UTHAI-Humanoid/UTHAI-Hardware/Mechanics/UTHAI_Properties.xlsx

 | UTHAI Humanoid
URDF | Link | Mass [kg] | Centor of mass [m] |  |  | Inertia [kg*m^2] taken at the center of mass |  |  |  |  |  | Inertia [kg*m^2] taken at the coordinate |  |  |  |  |  | Link
 |  |  | x | y | z | xx | xy | xz | yy | yz | zz | xx | xy | xz | yy | yz | zz
 | All | 3.56700000 | -0.00836813 | 0.00000000 | -0.31830739 | 0.31081793 | -0.00000313 | -0.00035731 | 0.28471758 | -0.00000024 | 0.03125190 | 0.67222493 | -0.00000313 | 0.00914389 | 0.64637436 | -0.00000037 | 0.03150169 | All
 | Body | 0.86500000 | -0.00557436 | 0.00000000 | -0.02356598 | 0.00656431 | -0.00000003 | -0.00000466 | 0.00067608 | 0.00000000 | 0.00664141 | 0.00704469 | -0.00000003 | 0.00010897 | 0.00118334 | 0.00000001 | 0.00666829 | Body
 | R Hip Yaw | 0.09100000 | 0.00000000 | -0.02500000 | -0.00735017 | 0.00014158 | 0.00000000 | 0.00000000 | 0.00002022 | 0.00000000 | 0.00014316 | 0.00020337 | 0.00000000 | 0.00000000 | 0.00002514 | 0.00001672 | 0.00020004 | R Hip Yaw
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
