UTHAI-Humanoid/UTHAI-Hardware/Mechanics/Drawing/Foot/Feet_L.JPG

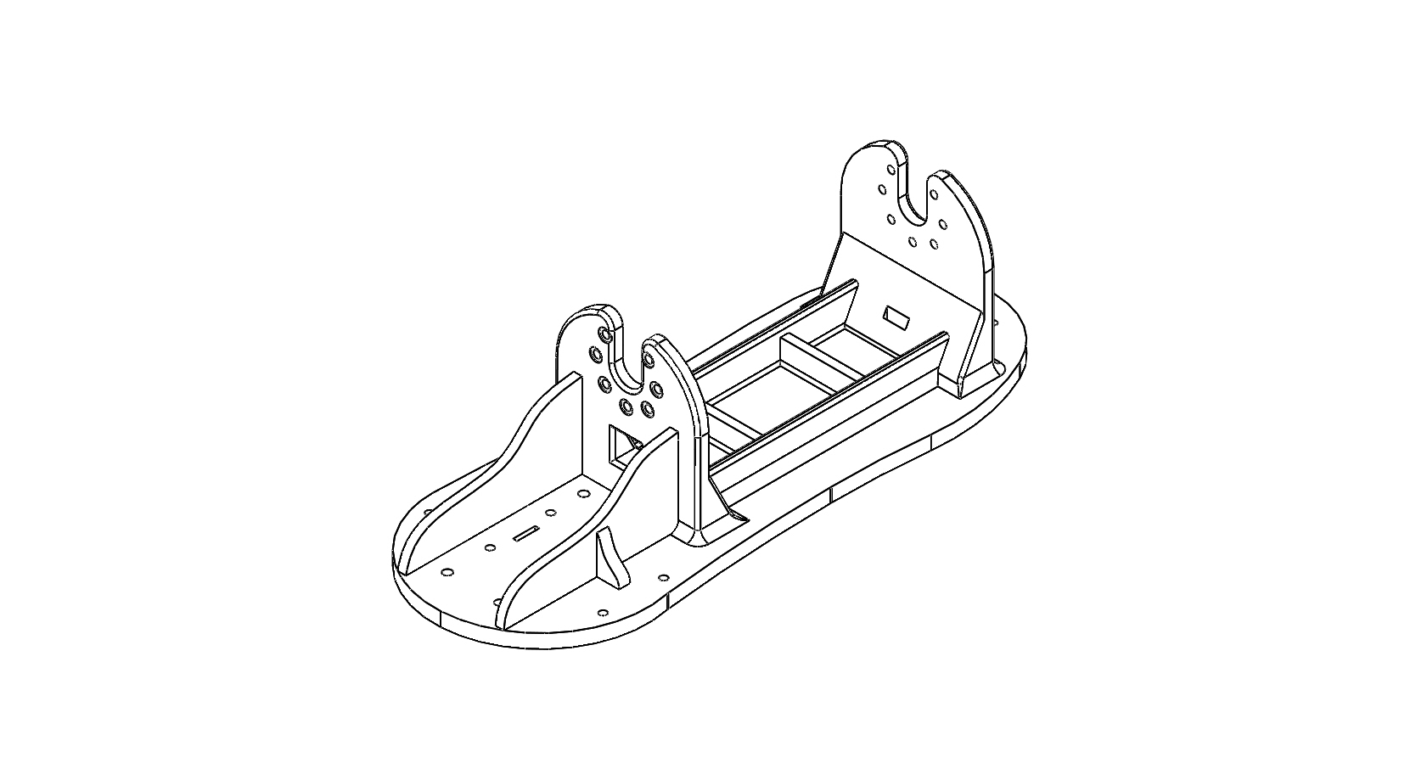
Mechanics/Drawing/Foot/Feet_L.JPG
