UTHAI-Humanoid/UTHAI-Hardware/Mechanics/Drawing/Hip.JPG

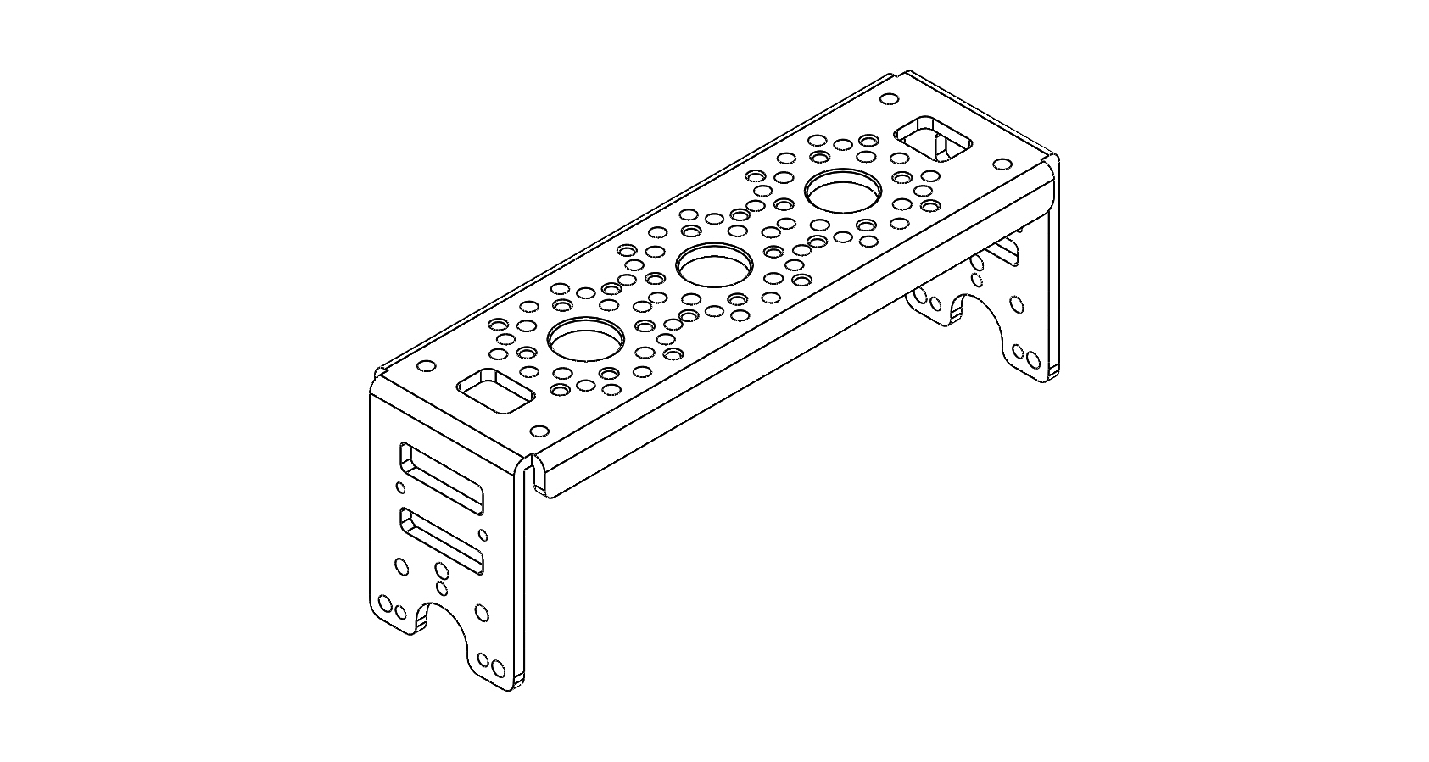
Mechanics/Drawing/Hip.JPG
