UTHAI-Humanoid/UTHAI-Hardware/Mechanics/Drawing/HipAnkle/LAnkle.JPG

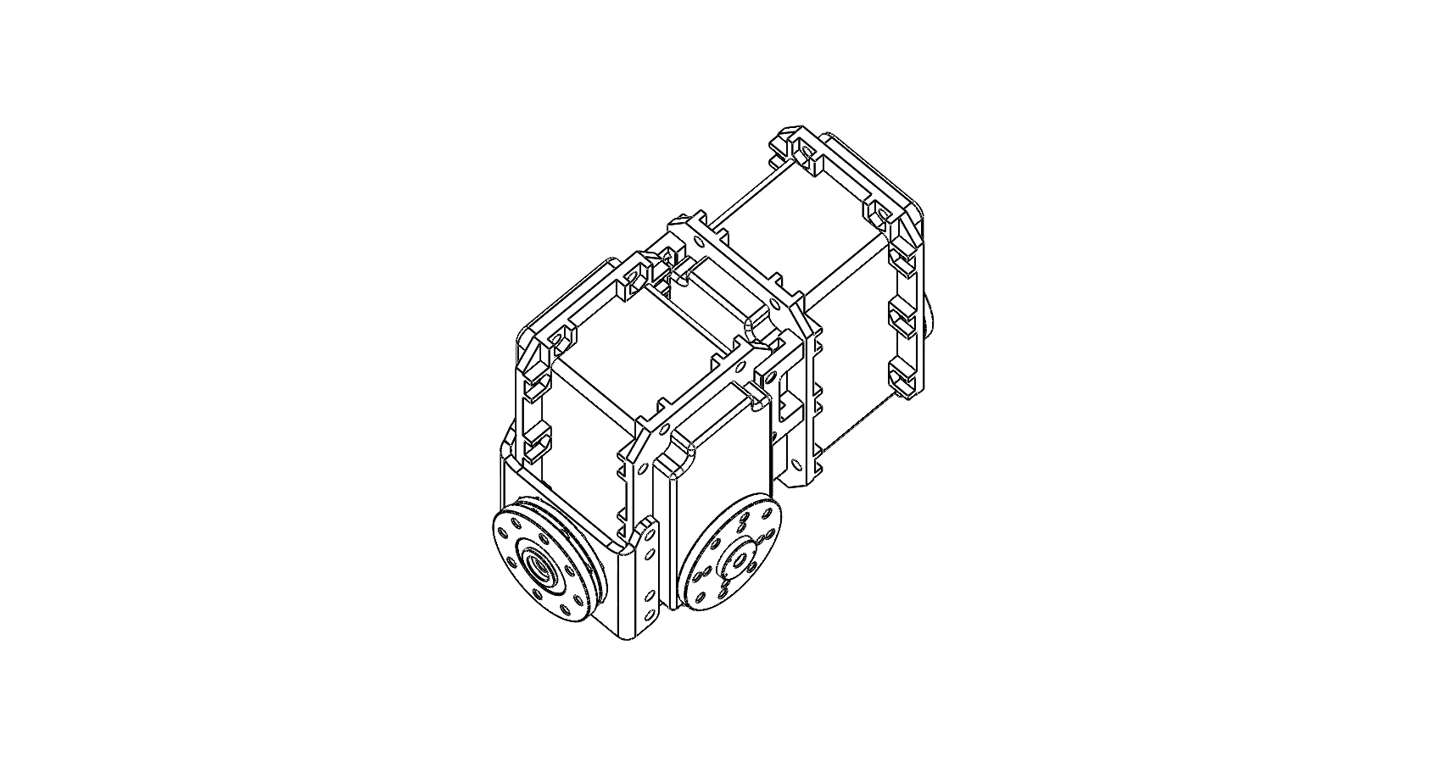
Mechanics/Drawing/HipAnkle/LAnkle.JPG
