UTHAI-Humanoid/UTHAI-Hardware/Mechanics/Drawing/HipAnkle/LHip.JPG

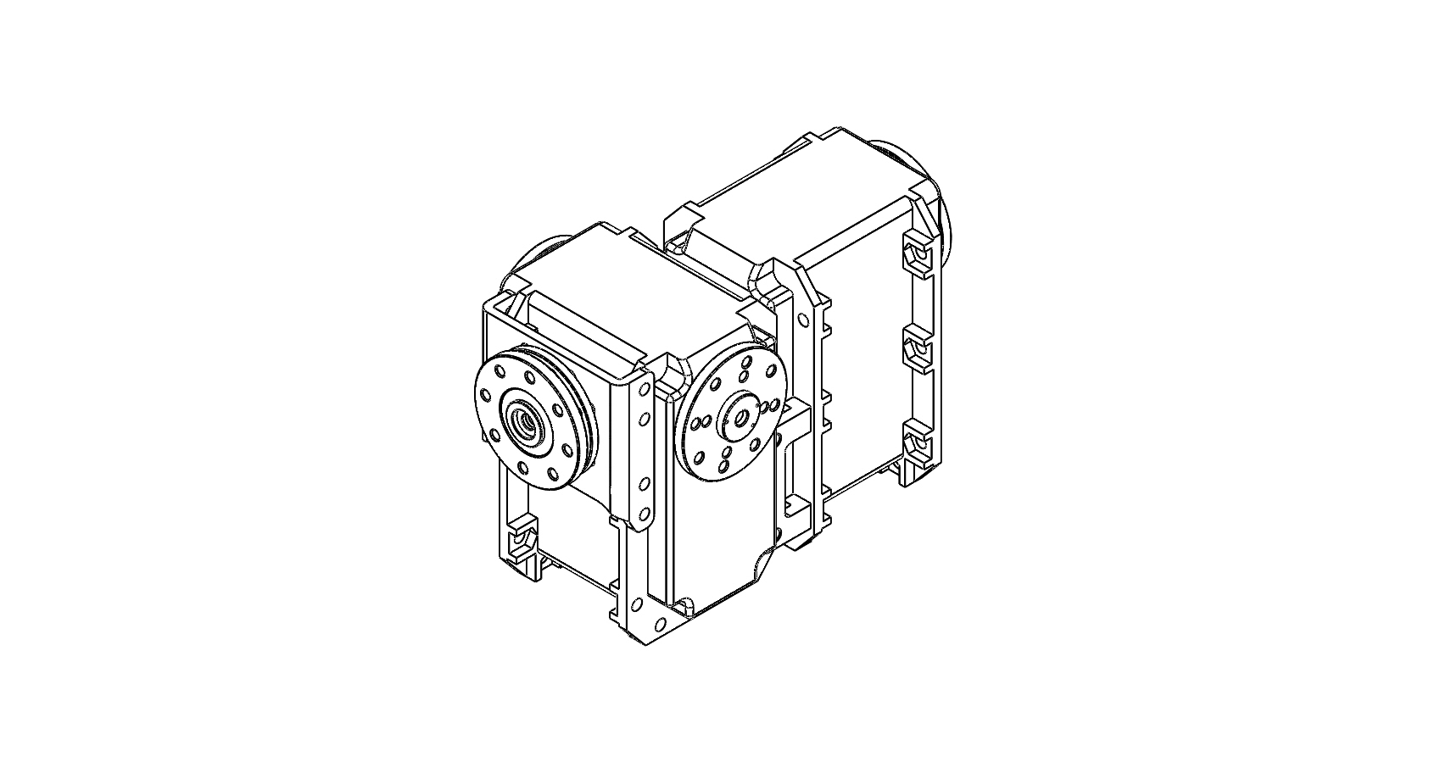
Mechanics/Drawing/HipAnkle/LHip.JPG
