UTHAI-Humanoid/UTHAI-Hardware/Mechanics/Drawing/HipAnkle/LHipC.JPG

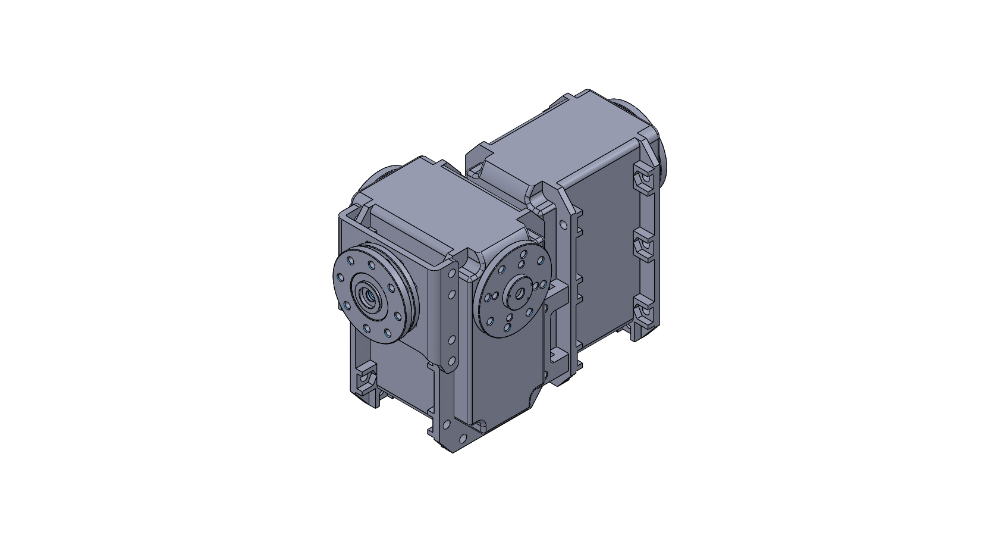
Mechanics/Drawing/HipAnkle/LHipC.JPG
