UTHAI-Humanoid/UTHAI-Hardware/Mechanics/Drawing/Pelvis.JPG

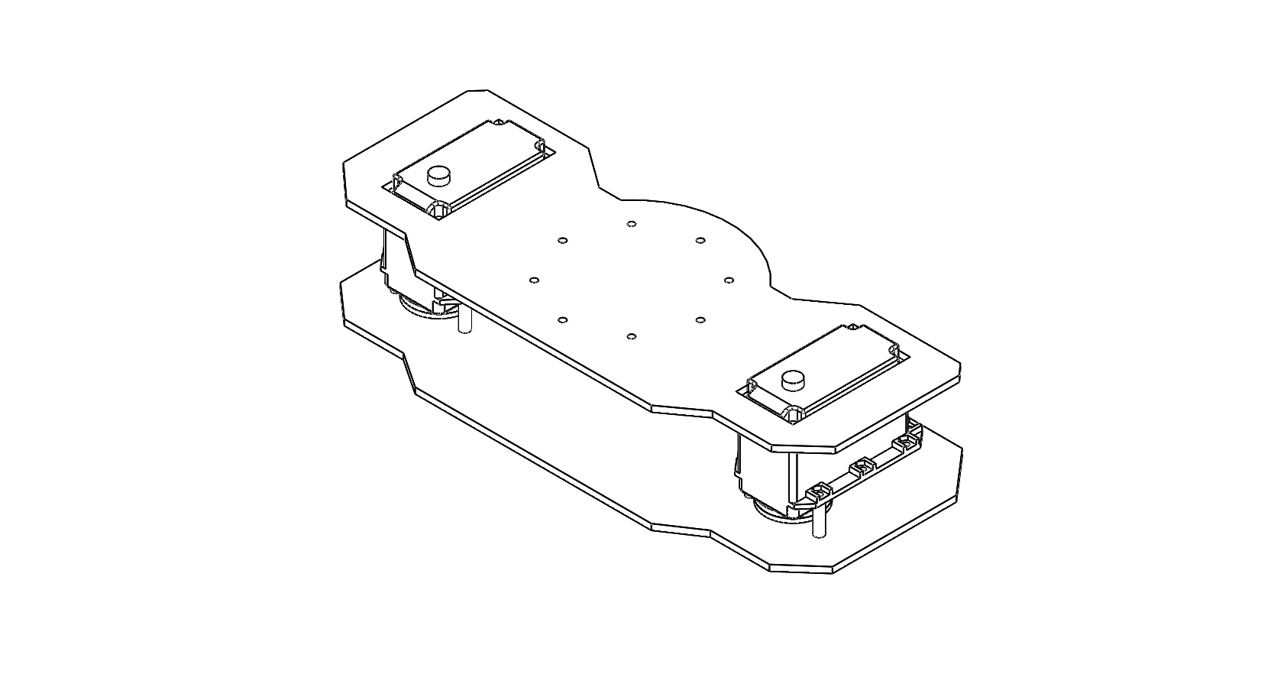
Mechanics/Drawing/Pelvis.JPG
