UTHAI-Humanoid/UTHAI-Hardware/Mechanics/Drawing/Shin/Shin.JPG

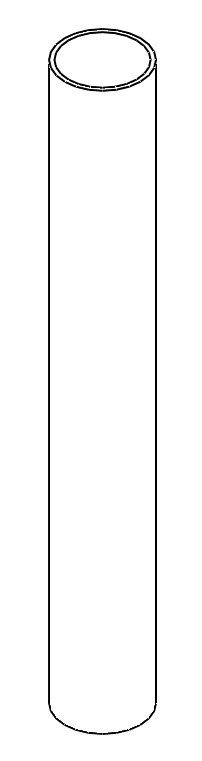
Mechanics/Drawing/Shin/Shin.JPG
