UTHAI-Humanoid/UTHAI-Hardware/Mechanics/Drawing/Shin/Shin_high.JPG

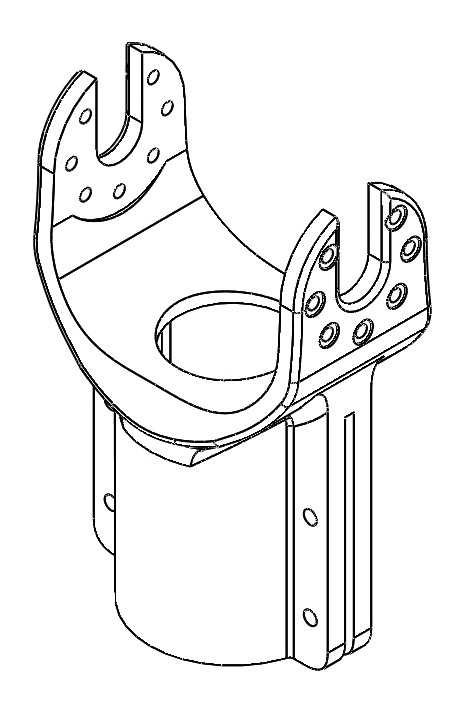
Mechanics/Drawing/Shin/Shin_high.JPG
