UTHAI-Humanoid/UTHAI-Hardware/Mechanics/Drawing/Shin/Shin_low.JPG

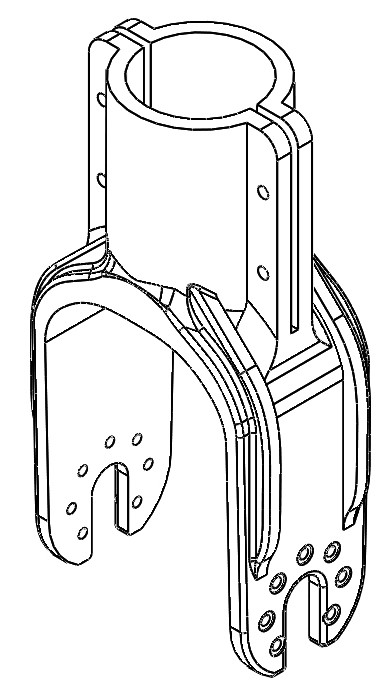
Mechanics/Drawing/Shin/Shin_low.JPG
