UTHAI-Humanoid/UTHAI-Hardware/Mechanics/Drawing/Shin/ShinAssem.JPG

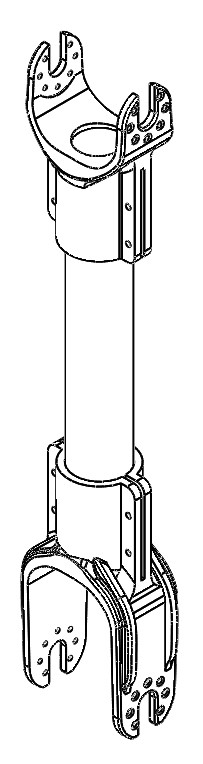
Mechanics/Drawing/Shin/ShinAssem.JPG
