UTHAI-Humanoid/UTHAI-Hardware/Mechanics/Drawing/Shin/ShinAssemC.JPG

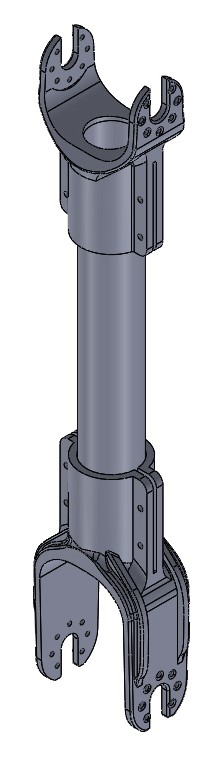
Mechanics/Drawing/Shin/ShinAssemC.JPG
