UTHAI-Humanoid/UTHAI-Hardware/Mechanics/Drawing/Thigh/EX-106+hon.JPG

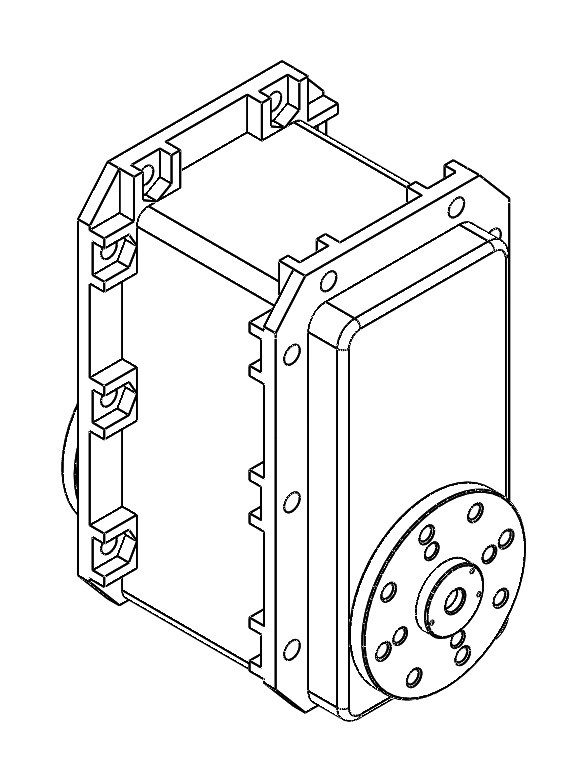
Mechanics/Drawing/Thigh/EX-106+hon.JPG
