UTHAI-Humanoid/UTHAI-Hardware/Mechanics/Drawing/Thigh/LEX-106+hon.JPG

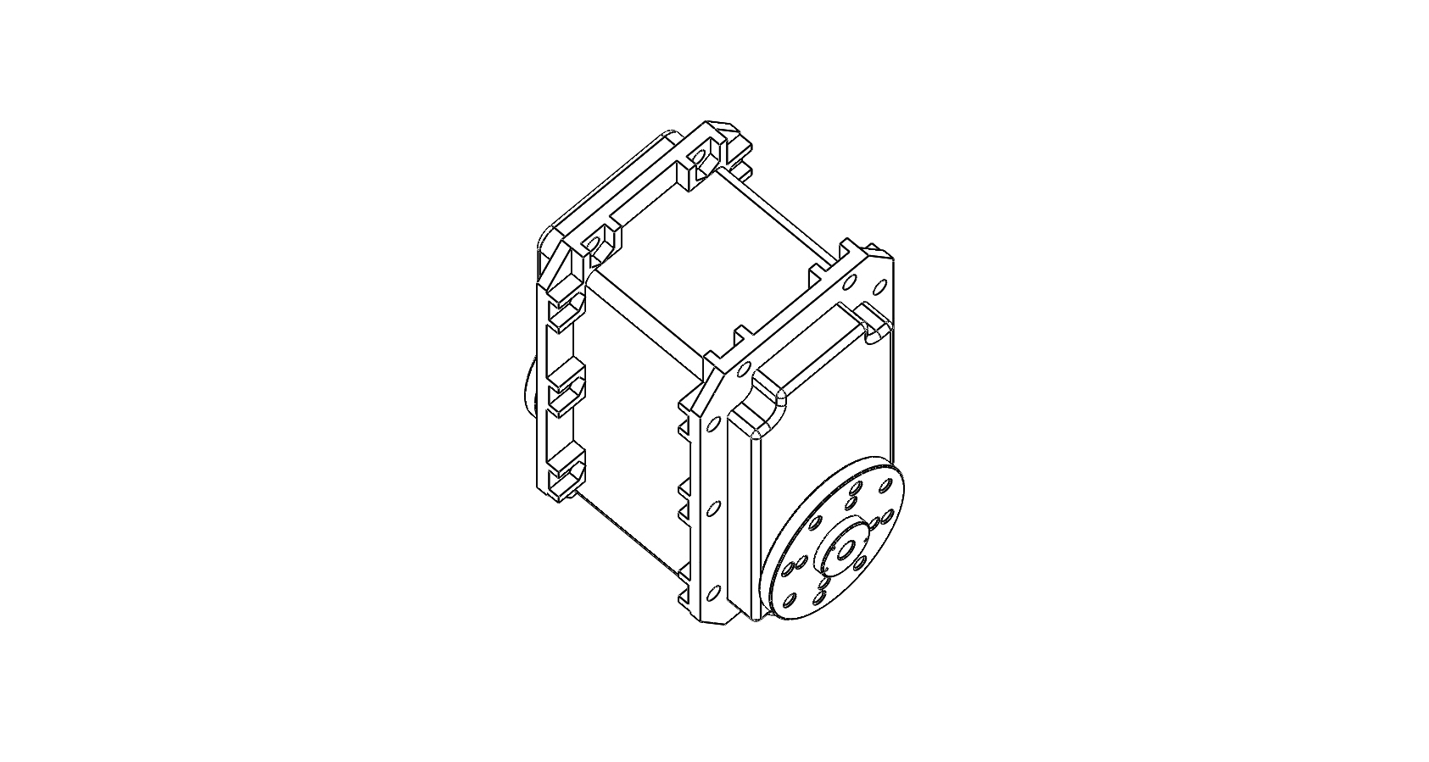
Mechanics/Drawing/Thigh/LEX-106+hon.JPG
