UTHAI-Humanoid/UTHAI-Hardware/Mechanics/Drawing/Thigh/LThighAssem.JPG

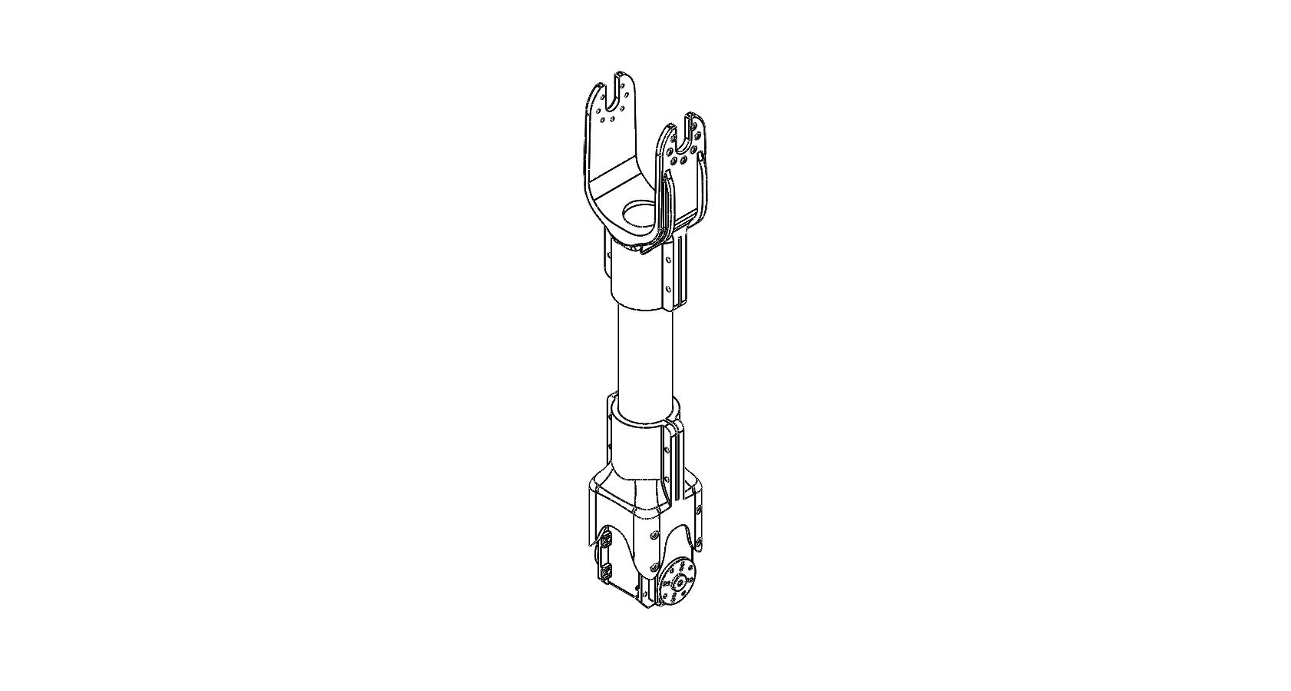
Mechanics/Drawing/Thigh/LThighAssem.JPG
