UTHAI-Humanoid/UTHAI-Hardware/Mechanics/Drawing/Thigh/Thigh.JPG

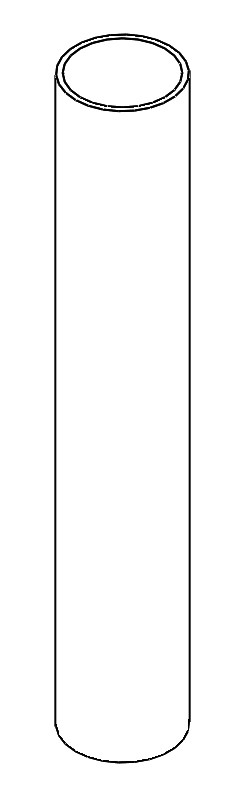
Mechanics/Drawing/Thigh/Thigh.JPG
