UTHAI-Humanoid/UTHAI-Hardware/Mechanics/Drawing/Thigh/Thigh_high.JPG

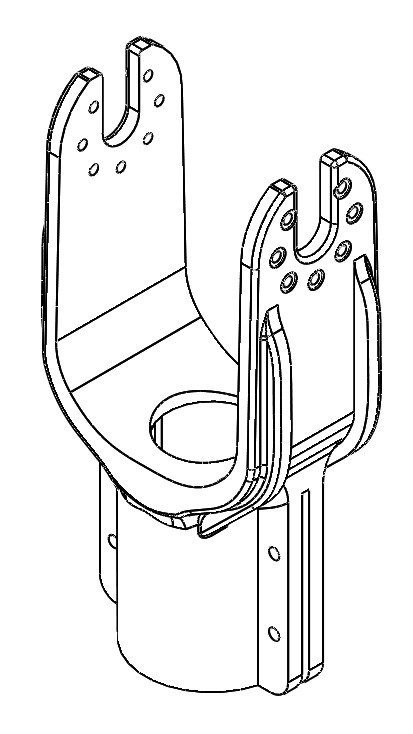
Mechanics/Drawing/Thigh/Thigh_high.JPG
