UTHAI-Humanoid/UTHAI-Hardware/Mechanics/Drawing/Thigh/Thigh_low.JPG

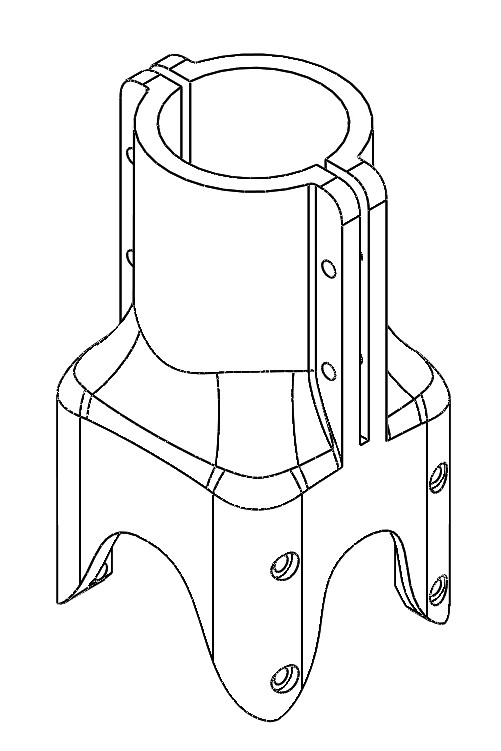
Mechanics/Drawing/Thigh/Thigh_low.JPG
