UTHAI-Humanoid/UTHAI-Hardware/Mechanics/Drawing/Thigh/ThighAssem.JPG

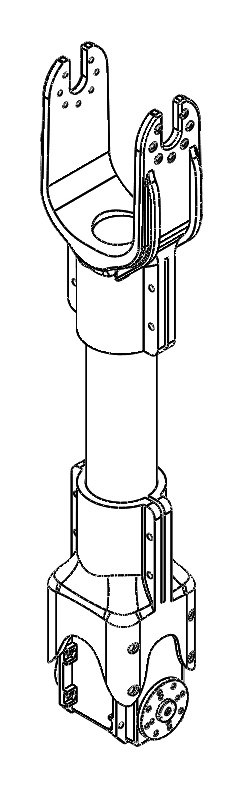
Mechanics/Drawing/Thigh/ThighAssem.JPG
