UTHAI-Humanoid/UTHAI-Hardware/Mechanics/Drawing/Thigh/ThighAssemC.JPG

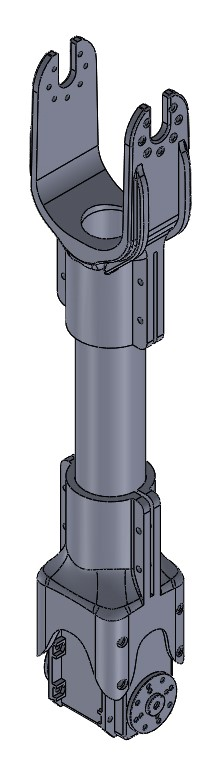
Mechanics/Drawing/Thigh/ThighAssemC.JPG
