UTHAI-Humanoid/UTHAI-Hardware/Mechanics/STL files/DH/r_hip_yaw.STL

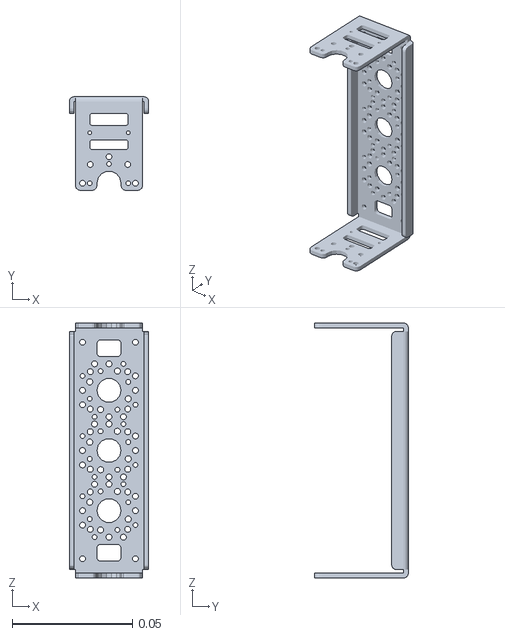
[picture p39: CAD file, 2018-03-09]
Mechanics/STL files/DH/r_hip_yaw.STL
0.033 x 0.039 x 0.106
