UTHAI-Humanoid/UTHAI-Hardware/Mechanics/STL files/URDF/r_ankle_roll.STL

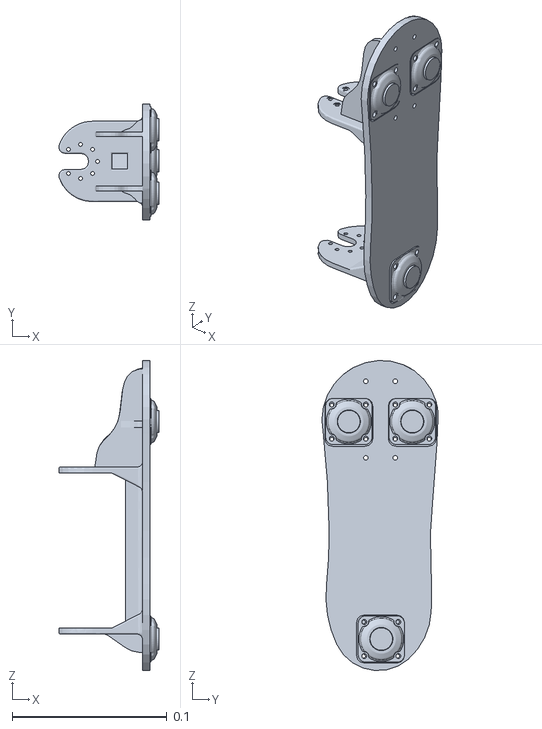
[picture p40: CAD file, 2018-03-10]
Mechanics/STL files/URDF/r_ankle_roll.STL
0.0648 x 0.0751 x 0.2
