UTHAI-Humanoid/UTHAI-Hardware/Mechanics/STL files/DH/l_ankle_pitch.STL

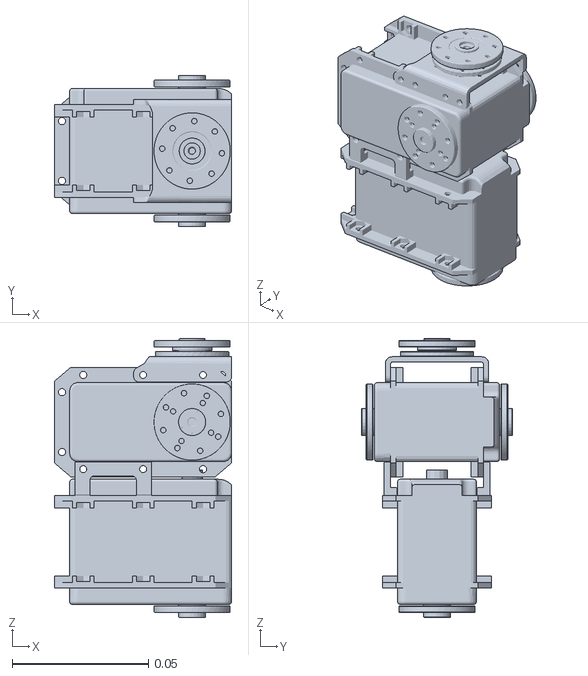
[picture p41: CAD file, 2018-03-09]
Mechanics/STL files/DH/l_ankle_pitch.STL
0.0651 x 0.0556 x 0.103
