UTHAI-Humanoid/UTHAI-Hardware/Mechanics/STL files/URDF/r_hip_pitch.STL

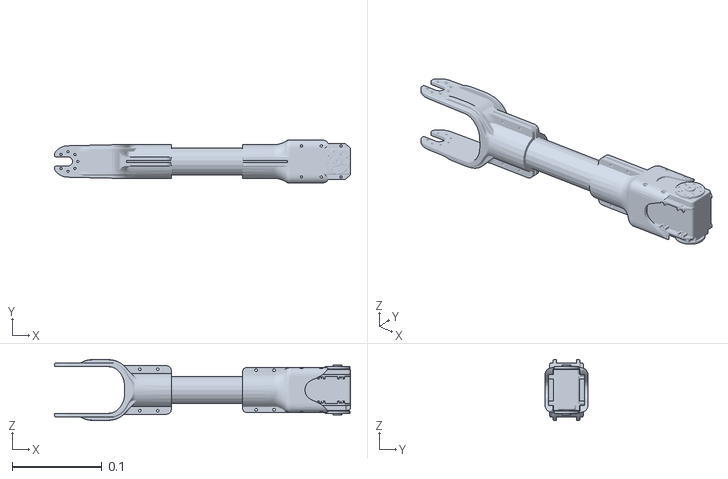
[picture p42: CAD file, 2018-03-09]
Mechanics/STL files/URDF/r_hip_pitch.STL
0.33 x 0.0482 x 0.0679
