UTHAI-Humanoid/UTHAI-Hardware/Mechanics/STL files/URDF/pelvis.STL

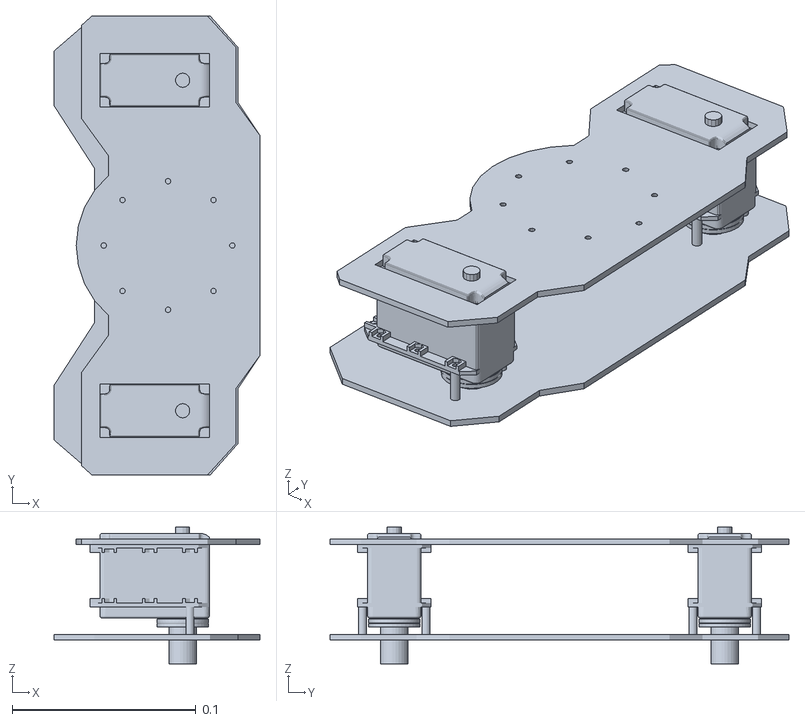
[picture p43: CAD file, 2018-03-09]
Mechanics/STL files/URDF/pelvis.STL
0.112 x 0.25 x 0.0744
