UTHAI-Humanoid/UTHAI-Hardware/Mechanics/STL files/URDF/l_knee_pitch.STL

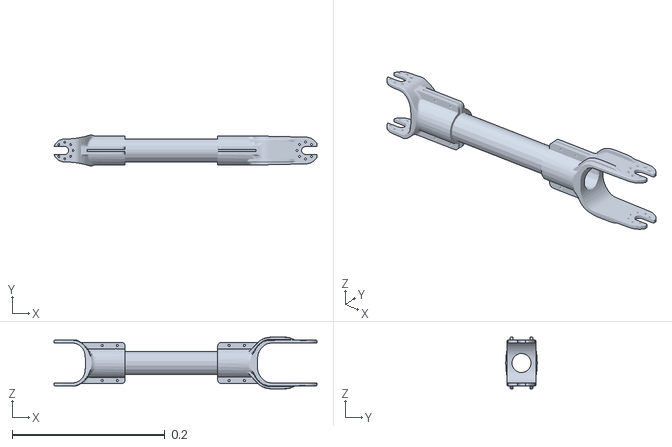
[picture p44: CAD file, 2018-03-09]
Mechanics/STL files/URDF/l_knee_pitch.STL
0.344 x 0.0413 x 0.0679
