UTHAI-Humanoid/UTHAI-Hardware/(list of files, cad)

Other CAD files:
Mechanics/STL files/URDF/l_hip_roll.STL
Mechanics/STL files/DH/r_ankle_roll.STL
Mechanics/STL files/DH/l_hip_pitch.STL
Mechanics/STL files/DH/pelvis.STL
Mechanics/STL files/DH/l_hip_roll.STL
Mechanics/STL files/URDF/l_ankle_roll.STL
Mechanics/STL files/DH/l_knee_pitch.STL
Mechanics/STL files/URDF/r_hip_roll.STL
Mechanics/STL files/DH/l_hip_yaw.STL
Mechanics/STL files/URDF/l_hip_pitch.STL
Mechanics/STL files/DH/r_ankle_pitch.STL
Mechanics/STL files/URDF/r_ankle_pitch.STL
Mechanics/STL files/DH/l_ankle_roll.STL
Mechanics/STL files/URDF/l_ankle_pitch.STL
Mechanics/STL files/DH/r_hip_roll.STL
Mechanics/STL files/URDF/r_hip_yaw.STL
Mechanics/STL files/DH/r_hip_pitch.STL
Mechanics/STL files/URDF/r_knee_pitch.STL
Mechanics/STL files/DH/r_knee_pitch.STL
Mechanics/STL files/URDF/l_hip_yaw.STL
