UTHAI-Humanoid/UTHAI-Hardware/(commit log)

2018-02-25 add cad file to mechanics part
    [AX12.SLDASM, AX12.iam, AX12.stp, Ankle.SLDASM, Ankle.SLDDRW, Assem_Pelvis.SLDASM, Assem_Shin.SLDASM, Assem_Thigh.SLDASM]
2018-02-25 add changelog file for cad
2018-02-25 add parts cad
    [AX12.SLDASM, AX12.iam, AX12.stp, Ankle.SLDASM, Ankle.SLDDRW, Assem_Pelvis.SLDASM, Assem_Shin.SLDASM, Assem_Thigh.SLDASM]
2018-02-25 add assembly manual
2018-02-26 make part as zip file make manual pdf
    [AX12.SLDASM, AX12.iam, AX12.stp, Ankle.SLDASM, Ankle.SLDDRW, Assem_Pelvis.SLDASM, Assem_Shin.SLDASM, Assem_Thigh.SLDASM]
2018-03-02 add STL files, DH and URDF convention.
    [l_ankle_pitch.STL, l_ankle_roll.STL, l_foot.STL, l_hip_pitch.STL, l_hip_roll.STL, l_hip_yaw.STL, l_knee_pitch.STL, pelvis.STL]
2018-03-02 add ex106 dimension
    [r_knee_pitch.STL]
2018-03-06 add dynamic properties and stl file [Not verified]
    [l_ankle_pitch.STL, l_ankle_roll.STL, l_foot.STL, l_hip_pitch.STL, l_hip_roll.STL, l_hip_yaw.STL, l_knee_pitch.STL, pelvis.STL]
2018-03-09 Merge branch 'master' of https://github.com/UTHAI-Humanoid/UTHAI-Hardware
    # Conflicts:
    # Mechanics/STL_URDF/r_knee_pitch.STL
    [UTHAI_Properties.xlsx, l_ankle_pitch.STL, l_ankle_pitch_dh.STL, l_ankle_pitch_urdf.STL, l_ankle_roll.STL, l_ankle_roll_dh.STL, l_ankle_roll_urdf.STL, l_hip_pitch.STL]
2018-03-10 fixed urdf stl files
    [l_hip_roll_urdf.STL, r_ankle_roll_urdf.STL]
2018-03-10 move files and add kinematics [unfinished]
2018-03-10 move files
    [l_ankle_pitch.STL, l_ankle_roll.STL, l_hip_pitch.STL, l_hip_roll.STL, l_hip_yaw.STL, l_knee_pitch.STL, pelvis.STL, r_ankle_pitch.STL]
2018-03-24 update inertia files [taken at the coordinate frame]
    [UTHAI_Properties.xlsx]
